Ayush-1988GH/Home-Automation/IMG_20260706_161920.jpg.jpeg

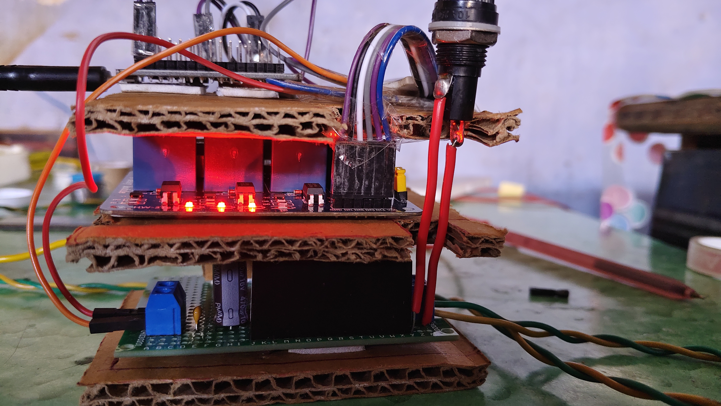
IMG_20260706_161920.jpg.jpeg
