Ayush-1988GH/Home-Automation/IMG_20260707_155042.jpg.jpeg

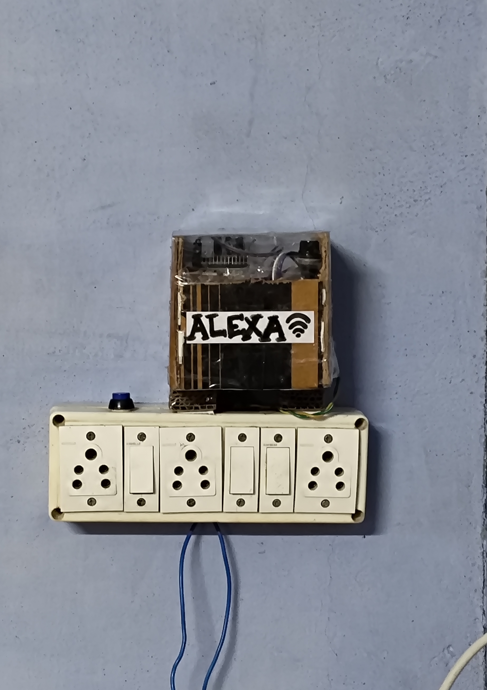
IMG_20260707_155042.jpg.jpeg
