Ayush-1988GH/Home-Automation/README.md

# Home-Automation
IoT based Home control with Google Voice Assisstant

Built using ESP8266 X Relays X Sinric Pro X Google Home
