Ayush-1988GH/Home-Automation/Working_and_Installation_Guide.docx

Smart Hybrid Switchboard

How It Works & How To Install It

Ayush Patel — ESP8266 / SinricPro / Alexa based IoT switchboard

# Part A — How the System Works

## A.1 System Summary

This switchboard has 3 sockets, each independently controllable in two ways at once: the existing physical wall switch, or remotely through the SinricPro app / Amazon Alexa. Both control paths work at any time — you never have to choose one over the other for daily use.

## A.2 Everyday Behaviour

Action | Result
Flip physical switch ON | Connected appliance turns ON immediately (no internet needed)
Flip physical switch OFF | Connected appliance turns OFF, and the app can now freely turn it back ON
Tap ON in SinricPro app / say "Alexa, turn on Switch 1" | Relay closes, appliance turns ON — works even if the physical switch is OFF
Tap OFF in app while physical switch is ON | Relay opens, but appliance stays ON because the physical switch is still completing the circuit

✔ TIP: For full app/voice control of a socket, leave its physical switch OFF and let the relay be the only thing turning that socket on and off. Use the physical switch as a manual override / backup, e.g. when there is no WiFi.

## A.3 What Keeps Running Automatically

- The ESP8266 boots and reconnects to the last saved WiFi network automatically whenever it is powered on.
- If it cannot connect to any saved network, it opens its own temporary WiFi hotspot ("ALEXA") for 3 minutes so a new network can be configured from a phone or laptop.
- Once connected, it links to your SinricPro account, and the app/Alexa integration works from anywhere with internet — you do not need to be on the same WiFi network as the switchboard.

## A.4 The Master Power Toggle

A separate physical push-button (self-locking) controls power to the ESP8266 + relay electronics only — it is wired before the AC-DC power module, completely independent of the 3 socket switches.

- Toggle OFF → the ESP8266, relay module and app/Alexa control all stop (zero power draw); sockets still work exactly as a normal manual switchboard would.
- Toggle ON → the ESP8266 boots fresh and reconnects automatically within a few seconds.

✔ TIP: This is the recommended way to "restart" the smart system if it ever seems unresponsive — toggle it off, wait a few seconds, toggle it back on.

# Part B — Installation Guide

## B.1 Before You Begin

⚠ WARNING: This installation involves 230V AC mains wiring. Always switch off the MCB / mains supply for the relevant circuit before opening or wiring the switchboard. If you are not fully confident working with live mains, have someone experienced check the wiring before first power-on.

- Confirm the MCB for the target circuit is OFF
- Confirm the custom AC-DC power module has already been tested standalone and outputs a safe ~5V (see Build Documentation, Section 5)
- Have the wiring diagram (attached separately) open for reference

## B.2 Physical Placement

1. Mount the assembled electronics (NodeMCU + relay module + AC-DC power supply board) inside the switchboard cavity or an adjoining enclosure, keeping the mains-side wiring (fuse, varistor, HLK AC input) physically separated from the low-voltage side (NodeMCU, relay control pins) as far as the enclosure allows.

2. Mount the master toggle switch (PBS-11A) in an accessible spot on the switchboard fascia or enclosure face.

3. Keep the relay module's opto-isolated boundary intact — do not route mains wiring across the relay board's isolation gap.

## B.3 Mains Wiring Sequence

1. Wire the incoming Live to a common bus feeding: all 3 manual switch inputs, all 3 relay COM terminals, and (via its own fuse + master toggle switch) the AC-DC module's AC input.

2. Wire the incoming Neutral directly to all 3 sockets' Neutral terminals and to the AC-DC module's other AC input pin — never through any switch or relay.

3. Wire Earth directly to all 3 sockets' Earth terminals — never through any switch or relay.

4. For each of the 3 channels: join that channel's manual switch output and its relay's NO terminal together at a proper connector block, then run a single wire from that block into the corresponding socket's Live terminal.

5. Connect the AC-DC module's DC output (+Vo / -Vo) to the NodeMCU's VIN and GND pins.

## B.4 First Power-On

1. Double-check all mains-side connections are secure and insulated (heat-shrink or proper connector housings) before restoring power.

2. Turn the MCB back ON.

3. Ensure the master toggle switch is ON — confirm the NodeMCU boots (visible onboard LED activity).

4. Confirm each socket responds correctly to its manual switch.

5. Open the SinricPro app (or ask Alexa) and confirm each device shows Online, then test ON/OFF for each channel.

## B.5 Troubleshooting Quick Reference

Symptom | Likely Cause / Fix
Device shows Offline in app | Check WiFi is 2.4GHz (ESP8266 cannot use 5GHz); check router/hotspot isn't blocking new devices
Connects to WiFi but SinricPro keeps disconnecting | Often an NTP/time-sync issue on the network — try a different WiFi/hotspot, or wait — the firmware retries automatically
Socket doesn't turn off from the app | Check whether the physical switch for that socket is ON — it will keep the load powered regardless of relay state (expected hybrid behaviour)
Nothing powers on at all | Check the master toggle switch position, and check the AC-DC module's fuse

## B.6 Safety Reminders

- Never work on the switchboard with the MCB on.
- Keep mains-side and low-voltage-side wiring visually separated wherever possible.
- Earth must always remain a direct, unswitched path to every socket.
- Re-check for loose connections periodically, especially at the shared switch+relay junction points, since these carry the full load current.

Working & Installation Guide
