Ayush-1988GH/Home-Automation/(commit log)

2026-07-10 Add files via upload
    Arduino Code for Iot application
2026-07-10 Add files via upload
    Complete Circuit Diagram
